alanmimms/WSPR-easy/hw/WSPR-ease.kicad_pcb

## KiCad design hw/WSPR-ease.kicad_pcb (2026-04-10)

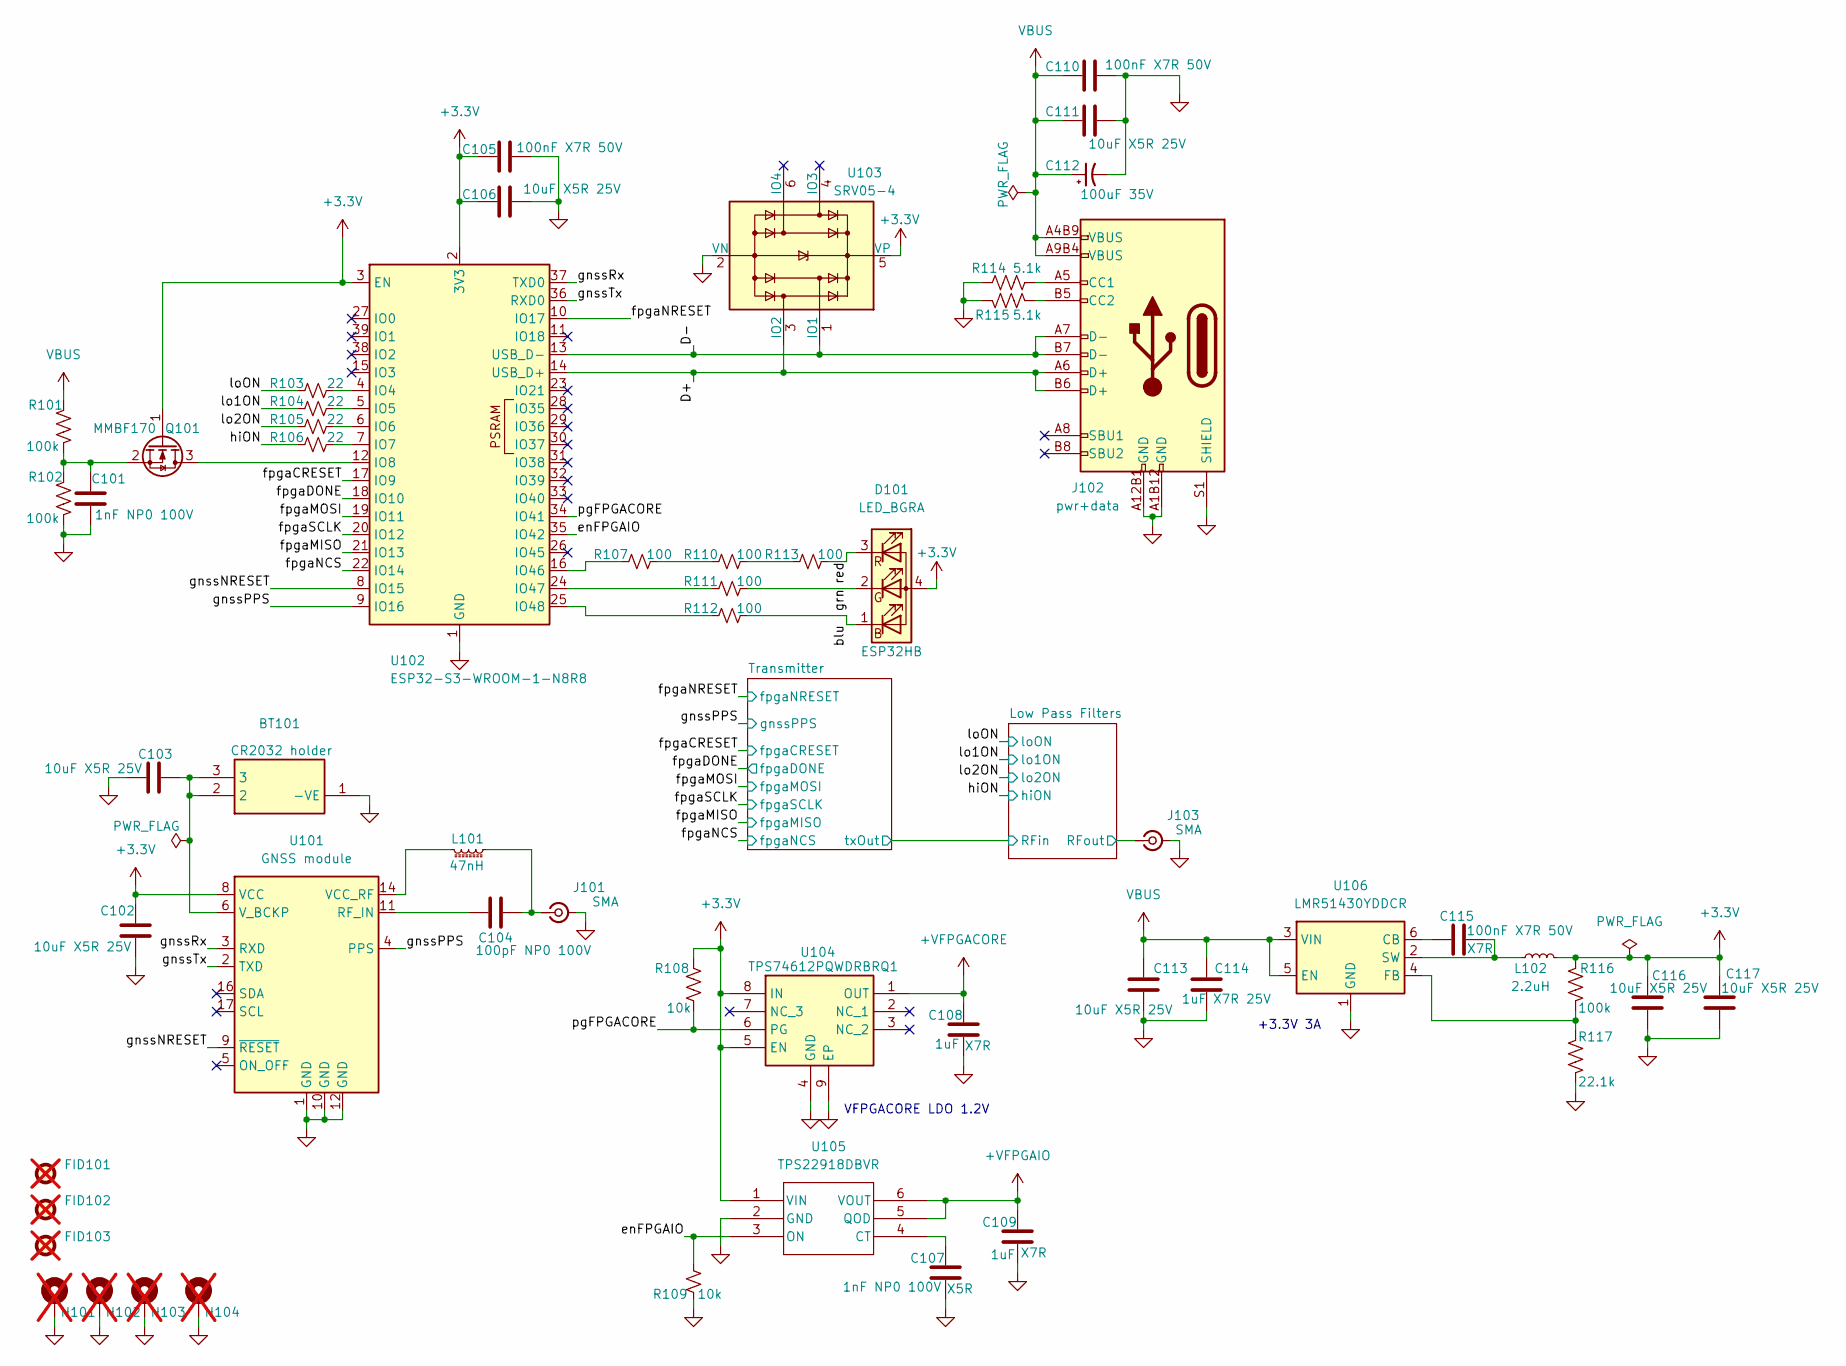
[picture p1: schematic WSPR-ease.kicad_sch, WSPR Ease]

Parts:
BT101: CR2032 holder; S8401-46; Mouser Part Number 855-S8401-46; LCSC C6750449
C101: 1nF NP0 100V; C_0603_1608Metric; MPN KGM15ACG2A102FT; LCSC C5182455
C102, C103, C106, C111: 10uF X5R 25V; C_0603_1608Metric; MPN CM105X5R106M25AT; LCSC C96446
C104: 100pF NP0 100V; C_0603_1608Metric; MPN KGM15ACG2A101FT; LCSC C106200
C105, C110: 100nF X7R 50V; C_0603_1608Metric; MPN KGM15BR71H104KT; LCSC C24452
C107: 1nF NP0 100V; C_0603_1608Metric; MPN KGM15ACG2A102FT; LCSC_PN C301928
C108, C109: 1uF; C_0402_1005Metric; MPN GRM155Z71A105KE1D; LCSC_PN C301928
C112: 100uF 35V; C_Elec_8x6.2; MPN MAL214297007E3; LCSC C1849748
C113: 10uF X5R 25V; C_0603_1608Metric; MPN CM105X5R106M25AT; LCSC_PN C327087
C114: 1uF X7R 25V; C_0603_1608Metric; MPN CM105X7R105K25AT; LCSC_PN C301928
C115: 100nF X7R 50V; C_0603_1608Metric; MPN KGM15BR71H104KT; LCSC_PN C24452
C116, C117: 10uF X5R 25V; C_0603_1608Metric; Manufacturer_Part_Number 81-GXT155R71E223KE1D; Mouser Part Number 963-MLAST168BB5106MT
D101: LED_BGRA; UHD111AFKAC3K23E1L3VG5ZB3Z3; MPN UHD111A-FKA-C3K23E1L3VG5ZB3Z3; Mouser_PN 941-UHD1AA3K3E3V53Z3
FID101, FID102, FID103: Fiducial; Fiducial_1mm_Mask2mm; LCSC DNP; not fitted
H101, H102, H103, H104: MountingHole_Pad; MountingHole_3.2mm_M3_ISO7380_Pad; LCSC DNP; not fitted
J101, J103: SMA; SMA_Amphenol_901-143_Horizontal; MPN SMA-J-P-H-RA-TH1; LCSC C496551
J102: pwr+data; USB_C_Receptacle_HRO_TYPE-C-31-M-12-bursted; MPN TYPE-C-31-M-12; LCSC_PN C165948
L101: 47nH; L_0603_1608Metric; MPN AIMC-0603-47NJ-T; LCSC C98076
L102: 2.2uH; L_1008_2520Metric; MPN AIML-1008HC-2R2M-T; LCSC_PN C86089
Q101: MMBF170; SOT-23; MPN MMBF170Q-13-F; LCSC C28871
R101, R102: 100k; R_0402_1005Metric; MPN CRT0402-FZ-1003GLF; LCSC C60491
R103, R104, R105, R106: 22; R_0402_1005Metric
R107, R110, R111, R112, R113: 100; R_0402_1005Metric
R108: 10k; R_0402_1005Metric; MPN CRT0402-FZ-1003GLF; LCSC_PN C728576
R109: 10k; R_0402_1005Metric
R114, R115: 5.1k; R_0402_1005Metric; MPN MCS04020C5101FE000; LCSC_PN C854378
R116: 100k; R_0402_1005Metric; MPN CRT0402-FZ-1003GLF; LCSC_PN C728576
R117: 22.1k; R_0402_1005Metric; MPN RT0402FRD0722K1L; LCSC_PN C284424
U101: GNSS module; ublox_MAX; MPN TESEO-LIV3R; LCSC C90770
U102: ESP32-S3-WROOM-1-N8R8; ESP32-S3-WROOM-1; Mouser Part Number ESP32-S3-WROOM-1-N8R8; LCSC C2913204
U103: SRV05-4; SOT-23-6; MPN SRV05-4.TCT; LCSC C2836319
U104: TPS74612PQWDRBRQ1; SON65P300X300X100-9N-D; MPN TPS74612PQWDRBRQ1; LCSC_PN C2868254
U105: TPS22918DBVR; DBV6_TEX; MPN TPS22918DBVR; LCSC_PN C131941
U106: LMR51430YDDCR; SOT-23-6; MPN LMR51430YDDCR; LCSC_PN C5185863

Connections:
+3.3V: C102.1, C105.1, C106.1, C116.1, C117.1, D101.4 (A), L102.2, Q101.1 (G), R108.2, R116.2, U101.8 (VCC), U102.2 (3V3), U102.3 (EN), U103.5 (VP), U104.5 (EN), U104.8 (IN), U105.1 (VIN); also elsewhere on the board
+VFPGACORE: C108.1, U104.1 (OUT); also elsewhere on the board
+VFPGAIO: C109.1, U105.5 (QOD), U105.6 (VOUT); also elsewhere on the board
/D+: J102.A6 (D+), J102.B6 (D+), U102.14 (USB_D+), U103.3 (IO2)
/D-: J102.A7 (D-), J102.B7 (D-), U102.13 (USB_D-), U103.1 (IO1)
/Low Pass Filters/RFout: J103.1 (In); also elsewhere on the board
/blu: D101.1 (BK), R112.2
/enFPGAIO: R109.2, U102.35 (IO42), U105.3 (ON)
/fpgaCRESET: U102.17 (IO9); also elsewhere on the board
/fpgaDONE: U102.18 (IO10); also elsewhere on the board
/fpgaMISO: U102.21 (IO13); also elsewhere on the board
/fpgaMOSI: U102.19 (IO11); also elsewhere on the board
/fpgaNCS: U102.22 (IO14); also elsewhere on the board
/fpgaNRESET: U102.10 (IO17); also elsewhere on the board
/fpgaSCLK: U102.20 (IO12); also elsewhere on the board
/gnssNRESET: U101.9 (~RESET), U102.8 (IO15)
/gnssPPS: U101.4 (PPS), U102.9 (IO16); also elsewhere on the board
/gnssRx: U101.3 (RXD), U102.37 (TXD0)
/gnssTx: U101.2 (TXD), U102.36 (RXD0)
/grn: D101.2 (GK), R111.2
/hiON: R106.1; also elsewhere on the board
/lo1ON: R104.1; also elsewhere on the board
/lo2ON: R105.1; also elsewhere on the board
/loON: R103.1; also elsewhere on the board
/pgFPGACORE: R108.1, U102.34 (IO41), U104.6 (PG)
/red: D101.3 (RK), R113.2
GND: BT101.1 (-VE), C101.2, C102.2, C103.1, C105.2, C106.2, C107.2, C108.2, C109.2, C110.2, C111.2, C112.2, C113.2, C114.2, C116.2, C117.2, H101.1, H102.1, H103.1, H104.1, J101.2 (Ext), J102.A1B12 (GND), J102.A12B1 (GND), J102.S1 (SHIELD), J103.2 (Ext), R102.2, R109.1, R114.2, R115.2, R117.1, U101.1 (GND), U101.10 (GND), U101.12 (GND), U102.1 (GND), U102.40 (GND), U102.41 (GND), U103.2 (VN), U104.4 (GND), U104.9 (EP), U105.2 (GND), U106.1 (GND); also elsewhere on the board
unnamed: C104.2, J101.1 (In), L101.2
unnamed: J102.A5 (CC1), R114.1
unnamed: J102.B5 (CC2), R115.1
unnamed: Q101.3 (D), U102.12 (IO8)
unnamed: C101.1, Q101.2 (S), R101.2, R102.1
unnamed: R107.2, R110.1
unnamed: R110.2, R113.1
unnamed: C104.1, U101.11 (RF_IN)
unnamed: L101.1, U101.14 (VCC_RF)
unnamed: BT101.2, BT101.3, C103.2, U101.6 (V_BCKP)
unnamed: R103.2, U102.4 (IO4)
unnamed: R104.2, U102.5 (IO5)
unnamed: R105.2, U102.6 (IO6)
unnamed: R106.2, U102.7 (IO7)
unnamed: R107.1, U102.16 (IO46)
unnamed: R111.1, U102.24 (IO47)
unnamed: R112.1, U102.25 (IO48)
unnamed: C107.1, U105.4 (CT)
unnamed: C115.1, U106.6 (CB)
unnamed: R116.1, R117.2, U106.4 (FB)
unnamed: C115.2, L102.1, U106.2 (SW)
VBUS: C110.1, C111.1, C112.1, C113.1, C114.1, J102.A4B9 (VBUS), J102.A9B4 (VBUS), R101.1, U106.3 (VIN), U106.5 (EN); also elsewhere on the board

Notes on the sheet:
VFPGACORE LDO 1.2V
+3.3V 3A

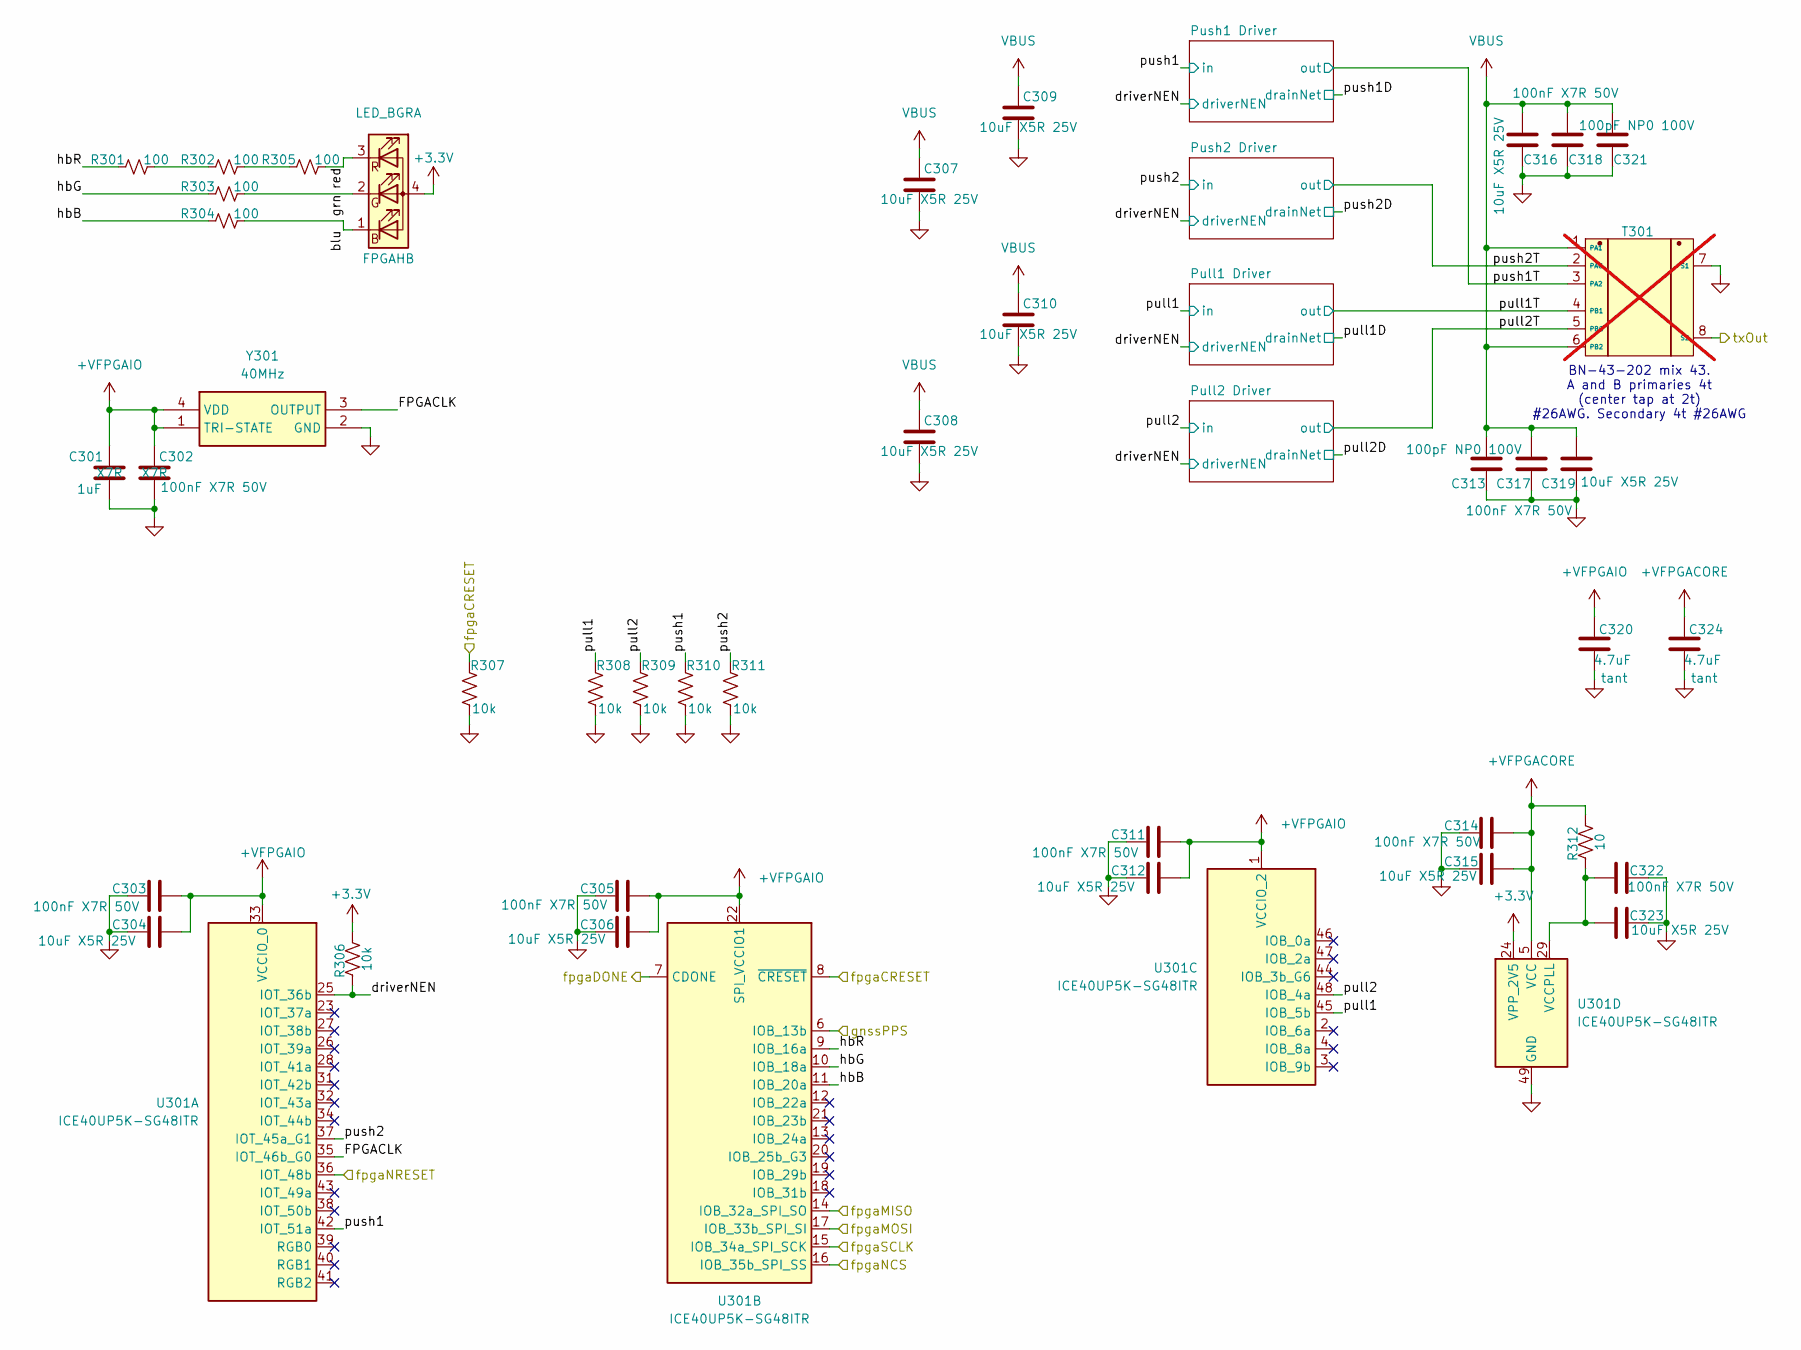
[picture p2: schematic tx.kicad_sch]

Parts:
C301: 1uF; C_0402_1005Metric; MPN GRM155Z71A105KE1D; LCSC_PN C301928
C302: 100nF X7R 50V; C_0603_1608Metric; MPN KGM15BR71H104KT; LCSC_PN C24452
C303, C305, C311, C314, C317, C318, C322: 100nF X7R 50V; C_0603_1608Metric; MPN KGM15BR71H104KT; LCSC C24452
C304, C306, C307, C308, C309, C310, C312, C315, C316, C319, C323: 10uF X5R 25V; C_0603_1608Metric; MPN CM105X5R106M25AT; LCSC C96446
C313, C321: 100pF NP0 100V; C_0603_1608Metric; MPN KGM15ACG2A101FT; LCSC C106200
C320, C324: 4.7uF; C_0402_1005Metric; MPN CM05X5R475M10AH; LCSC_PN C18535241
D301: LED_BGRA; UHD111AFKAC3K23E1L3VG5ZB3Z3; MPN UHD111A-FKA-C3K23E1L3VG5ZB3Z3; Mouser_PN 941-UHD1AA3K3E3V53Z3
R301, R302, R303, R304, R305: 100; R_0402_1005Metric
R306: 10k; R_0402_1005Metric; MPN MCT06030C1009FP500; LCSC C2907091
R307, R308, R309, R310, R311: 10k; R_0402_1005Metric; MPN MCS04020C1002FE000; LCSC C60490
R312: 10; R_0603_1608Metric; MPN MCT06030C1009FP500; LCSC C2907091
T301: BN-43-202_DualPri_CTSec; bn-43-202-horizontal; MPN 2843000202; LCSC C7174817; not fitted
U301: ICE40UP5K-SG48ITR; QFN-48-1EP_7x7mm_P0.5mm_EP5.6x5.6mm; MPN ICE40UP5K-SG48I; LCSC C2678152
Y301: 40MHz; ECSTXO201633400TR; MPN ECS-TXO-2016-33-400-TR; LCSC_PN C2451471

Connections:
+3.3V: D301.4 (A), R306.2, U301.24 (VPP_2V5); also elsewhere on the board
+VFPGACORE: C314.2, C315.2, C324.1, R312.2, U301.5 (VCC), U301.30 (VCC); also elsewhere on the board
+VFPGAIO: C301.1, C302.1, C303.2, C304.2, C305.2, C306.2, C311.2, C312.2, C320.1, U301.1 (VCCIO_2), U301.22 (SPI_VCCIO1), U301.33 (VCCIO_0), Y301.1 (TRI-STATE), Y301.4 (VDD); also elsewhere on the board
/Low Pass Filters/RFin: T301.8 (S2); also elsewhere on the board
/Transmitter/FPGACLK: U301.35 (IOT_46b_G0), Y301.3 (OUTPUT)
/Transmitter/blu: D301.1 (BK), R304.2
/Transmitter/driverNEN: R306.1, U301.25 (IOT_36b); also elsewhere on the board
/Transmitter/grn: D301.2 (GK), R303.2
/Transmitter/hbB: R304.1, U301.11 (IOB_20a)
/Transmitter/hbG: R303.1, U301.10 (IOB_18a)
/Transmitter/hbR: R301.1, U301.9 (IOB_16a)
/Transmitter/pull1: R308.1, U301.45 (IOB_5b); also elsewhere on the board
/Transmitter/pull1T: T301.4 (PB1); also elsewhere on the board
/Transmitter/pull2: R309.1, U301.48 (IOB_4a); also elsewhere on the board
/Transmitter/pull2T: T301.5 (PBC); also elsewhere on the board
/Transmitter/push1: R310.1, U301.42 (IOT_51a); also elsewhere on the board
/Transmitter/push1T: T301.3 (PA2); also elsewhere on the board
/Transmitter/push2: R311.1, U301.37 (IOT_45a_G1); also elsewhere on the board
/Transmitter/push2T: T301.2 (PAC); also elsewhere on the board
/Transmitter/red: D301.3 (RK), R305.2
/fpgaCRESET: R307.1, U301.8 (~CRESET); also elsewhere on the board
/fpgaDONE: U301.7 (CDONE); also elsewhere on the board
/fpgaMISO: U301.14 (IOB_32a_SPI_SO); also elsewhere on the board
/fpgaMOSI: U301.17 (IOB_33b_SPI_SI); also elsewhere on the board
/fpgaNCS: U301.16 (IOB_35b_SPI_SS); also elsewhere on the board
/fpgaNRESET: U301.36 (IOT_48b); also elsewhere on the board
/fpgaSCLK: U301.15 (IOB_34a_SPI_SCK); also elsewhere on the board
/gnssPPS: U301.6 (IOB_13b); also elsewhere on the board
GND: C301.2, C302.2, C303.1, C304.1, C305.1, C306.1, C307.1, C308.1, C309.1, C310.1, C311.1, C312.1, C313.1, C314.1, C315.1, C316.1, C317.1, C318.1, C319.1, C320.2, C321.1, C322.1, C323.1, C324.2, R307.2, R308.2, R309.2, R310.2, R311.2, T301.7 (S1), U301.49 (GND), Y301.2 (GND); also elsewhere on the board
unnamed: R301.2, R302.1
unnamed: R302.2, R305.1
unnamed: C322.2, C323.2, R312.1, U301.29 (VCCPLL)
VBUS: C307.2, C308.2, C309.2, C310.2, C313.2, C316.2, C317.2, C318.2, C319.2, C321.2, T301.1 (PA1), T301.6 (PB2); also elsewhere on the board

Notes on the sheet:
BN-43-202 mix 43. A and B primaries 4t (center tap at 2t) #26AWG. Secondary 4t #26AWG

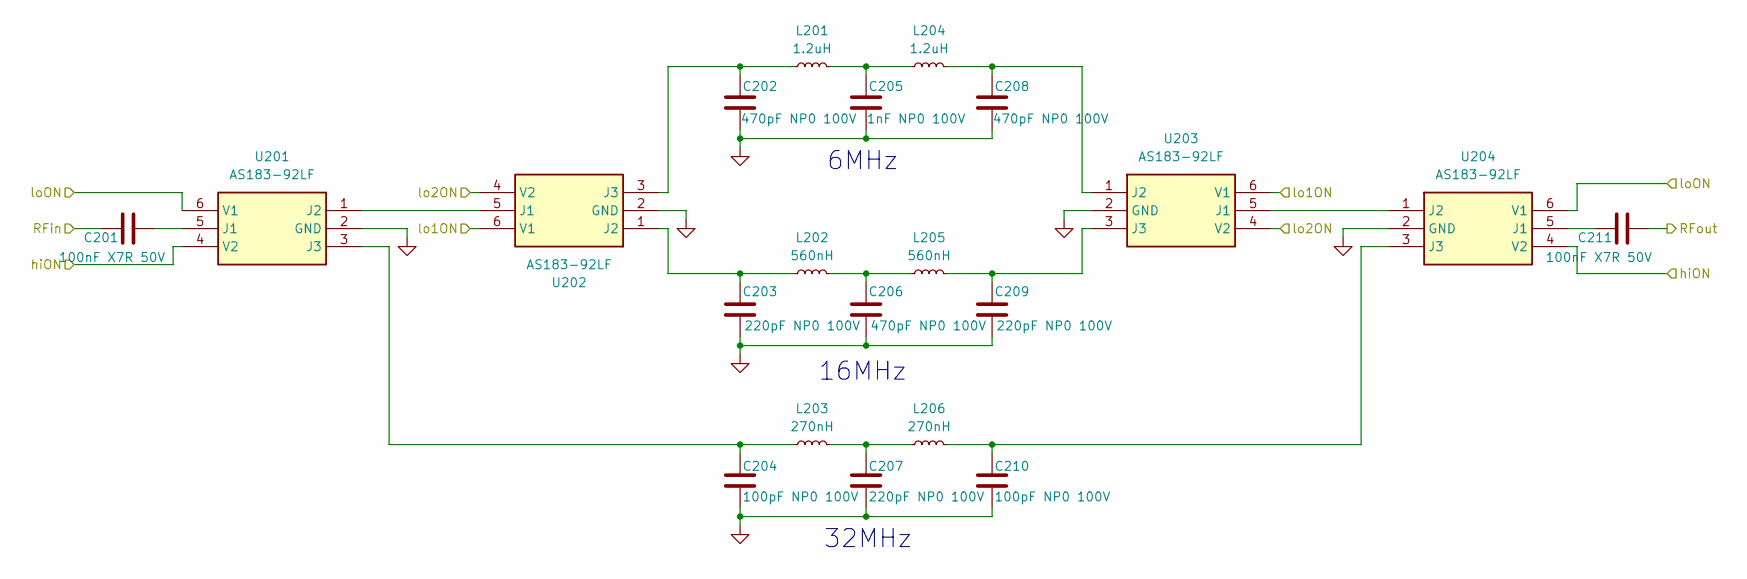
[picture p3: schematic LPFs.kicad_sch, Low Pass Filters]

Parts:
C201, C211: 100nF X7R 50V; C_0603_1608Metric; MPN KGM15BR71H104KT; LCSC C24452
C202, C206, C208: 470pF NP0 100V; C_0603_1608Metric; MPN GCM1885C2A471FA6D; LCSC C106259
C203, C207, C209: 220pF NP0 100V; C_0603_1608Metric; MPN GCM1885C2A221FA6D; LCSC C107001
C204, C210: 100pF NP0 100V; C_0603_1608Metric; MPN KGM15ACG2A101FT; LCSC C106200
C205: 1nF NP0 100V; C_0603_1608Metric; MPN KGM15ACG2A102FT; LCSC C5182455
L201, L204: 1.2uH; L_1008_2520Metric; MPN CW252016-1R2J; LCSC C2044063
L202, L205: 560nH; L_1008_2520Metric; MPN LQW2UASR56G00L; LCSC C6364717
L203, L206: 270nH; L_0805_2012Metric; MPN CW252016-R27J; LCSC C404430
U201, U202, U203, U204: AS183-92LF; SOT65P220X110-6N; Mouser Part Number 873-AS183-92LF

Connections:
/Low Pass Filters/RFin: C201.1; also elsewhere on the board
/Low Pass Filters/RFout: C211.2; also elsewhere on the board
/hiON: U201.4 (V2), U204.4 (V2); also elsewhere on the board
/lo1ON: U202.6 (V1), U203.6 (V1); also elsewhere on the board
/lo2ON: U202.4 (V2), U203.4 (V2); also elsewhere on the board
/loON: U201.6 (V1), U204.6 (V1); also elsewhere on the board
GND: C202.2, C203.2, C204.2, C205.2, C206.2, C207.2, C208.2, C209.2, C210.2, U201.2 (GND), U202.2 (GND), U203.2 (GND), U204.2 (GND); also elsewhere on the board
unnamed: C205.1, L201.2, L204.1
unnamed: C206.1, L202.2, L205.1
unnamed: C207.1, L203.2, L206.1
unnamed: C201.2, U201.5 (J1)
unnamed: U201.1 (J2), U202.5 (J1)
unnamed: C204.1, L203.1, U201.3 (J3)
unnamed: C203.1, L202.1, U202.1 (J2)
unnamed: C202.1, L201.1, U202.3 (J3)
unnamed: U203.5 (J1), U204.1 (J2)
unnamed: C208.1, L204.2, U203.1 (J2)
unnamed: C209.1, L205.2, U203.3 (J3)
unnamed: C211.1, U204.5 (J1)
unnamed: C210.1, L206.2, U204.3 (J3)

Notes on the sheet:
6MHz
32MHz
16MHz

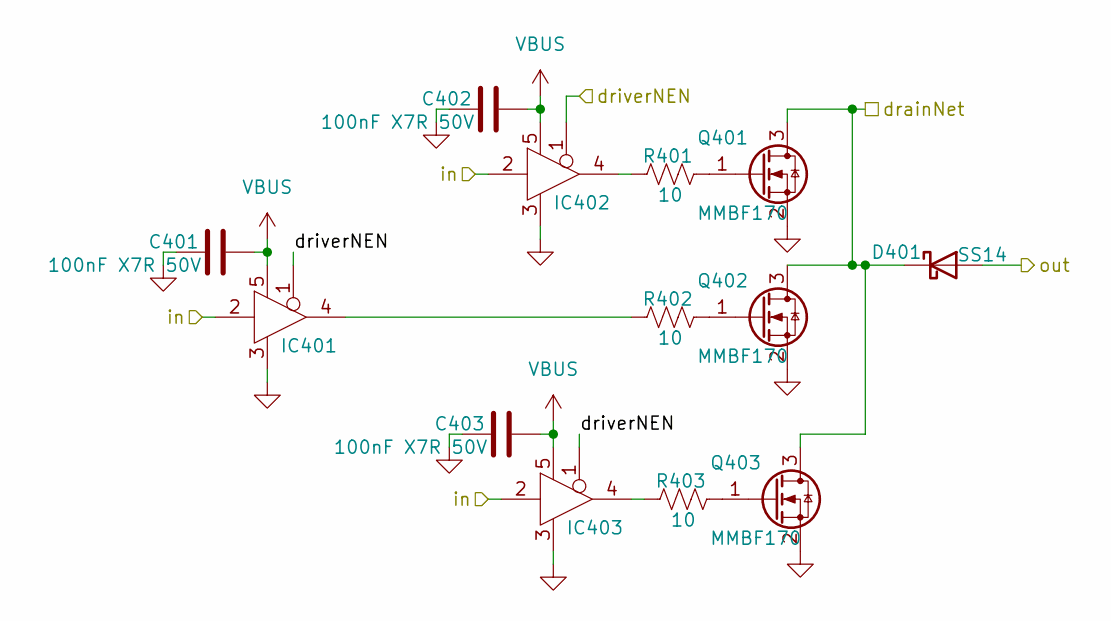
[picture p4: schematic phase-driver.kicad_sch]

Parts:
C401, C402, C403: 100nF X7R 50V; C_0603_1608Metric; MPN KGM15BR71H104KT; LCSC C24452
D401: SS14; D_SMA; MPN SS14; LCSC C83852
IC401, IC402, IC403: SN74AHCT1G125DRLR; SOTFL50P160X60-5N; Mouser Part Number 595-SN74AHCT1G125DRL
Q401, Q402, Q403: MMBF170; SOT-23; MPN MMBF170Q-13-F; LCSC C28871
R401, R402, R403: 10; R_0603_1608Metric; MPN MCT06030C1009FP500; LCSC C2907091

Connections:
/Transmitter/driverNEN: IC401.1 (~OE), IC402.1 (~OE), IC403.1 (~OE); also elsewhere on the board
/Transmitter/push1: IC401.2 (A), IC402.2 (A), IC403.2 (A); also elsewhere on the board
/Transmitter/push1D: D401.1 (K), Q401.3 (D), Q402.3 (D), Q403.3 (D)
/Transmitter/push1T: D401.2 (A); also elsewhere on the board
GND: C401.1, C402.1, C403.1, IC401.3 (GND), IC402.3 (GND), IC403.3 (GND), Q401.2 (S), Q402.2 (S), Q403.2 (S); also elsewhere on the board
unnamed: IC401.4 (Y), R402.1
unnamed: IC402.4 (Y), R401.1
unnamed: IC403.4 (Y), R403.1
unnamed: Q401.1 (G), R401.2
unnamed: Q402.1 (G), R402.2
unnamed: Q403.1 (G), R403.2
VBUS: C401.2, C402.2, C403.2, IC401.5 (VCC), IC402.5 (VCC), IC403.5 (VCC); also elsewhere on the board

Parts of its further copies:
C501, C502, C503, C601, C602, C603, C701, C702, C703: 100nF X7R 50V; C_0603_1608Metric; MPN KGM15BR71H104KT; LCSC C24452
D501, D601, D701: SS14; D_SMA; MPN SS14; LCSC C83852
IC501, IC502, IC503, IC601, IC602, IC603, IC701, IC702, IC703: SN74AHCT1G125DRLR; SOTFL50P160X60-5N; Mouser Part Number 595-SN74AHCT1G125DRL
Q501, Q502, Q503, Q601, Q602, Q603, Q701, Q702, Q703: MMBF170; SOT-23; MPN MMBF170Q-13-F; LCSC C28871
R501, R502, R503, R601, R602, R603, R701, R702, R703: 10; R_0603_1608Metric; MPN MCT06030C1009FP500; LCSC C2907091

Connections of its further copies:
/Transmitter/driverNEN: IC501.1 (~OE), IC502.1 (~OE), IC503.1 (~OE), IC601.1 (~OE), IC602.1 (~OE), IC603.1 (~OE), IC701.1 (~OE), IC702.1 (~OE), IC703.1 (~OE); also elsewhere on the board
/Transmitter/pull1: IC601.2 (A), IC602.2 (A), IC603.2 (A); also elsewhere on the board
/Transmitter/pull1D: D601.1 (K), Q601.3 (D), Q602.3 (D), Q603.3 (D)
/Transmitter/pull1T: D601.2 (A); also elsewhere on the board
/Transmitter/pull2: IC701.2 (A), IC702.2 (A), IC703.2 (A); also elsewhere on the board
/Transmitter/pull2D: D701.1 (K), Q701.3 (D), Q702.3 (D), Q703.3 (D)
/Transmitter/pull2T: D701.2 (A); also elsewhere on the board
/Transmitter/push2: IC501.2 (A), IC502.2 (A), IC503.2 (A); also elsewhere on the board
/Transmitter/push2D: D501.1 (K), Q501.3 (D), Q502.3 (D), Q503.3 (D)
/Transmitter/push2T: D501.2 (A); also elsewhere on the board
GND: C501.1, C502.1, C503.1, C601.1, C602.1, C603.1, C701.1, C702.1, C703.1, IC501.3 (GND), IC502.3 (GND), IC503.3 (GND), IC601.3 (GND), IC602.3 (GND), IC603.3 (GND), IC701.3 (GND), IC702.3 (GND), IC703.3 (GND), Q501.2 (S), Q502.2 (S), Q503.2 (S), Q601.2 (S), Q602.2 (S), Q603.2 (S), Q701.2 (S), Q702.2 (S), Q703.2 (S); also elsewhere on the board
unnamed: IC501.4 (Y), R502.1
unnamed: IC502.4 (Y), R501.1
unnamed: IC503.4 (Y), R503.1
unnamed: IC601.4 (Y), R602.1
unnamed: IC602.4 (Y), R601.1
unnamed: IC603.4 (Y), R603.1
unnamed: IC701.4 (Y), R702.1
unnamed: IC702.4 (Y), R701.1
unnamed: IC703.4 (Y), R703.1
unnamed: Q501.1 (G), R501.2
unnamed: Q502.1 (G), R502.2
unnamed: Q503.1 (G), R503.2
unnamed: Q601.1 (G), R601.2
unnamed: Q602.1 (G), R602.2
unnamed: Q603.1 (G), R603.2
unnamed: Q701.1 (G), R701.2
unnamed: Q702.1 (G), R702.2
unnamed: Q703.1 (G), R703.2
VBUS: C501.2, C502.2, C503.2, C601.2, C602.2, C603.2, C701.2, C702.2, C703.2, IC501.5 (VCC), IC502.5 (VCC), IC503.5 (VCC), IC601.5 (VCC), IC602.5 (VCC), IC603.5 (VCC), IC701.5 (VCC), IC702.5 (VCC), IC703.5 (VCC); also elsewhere on the board

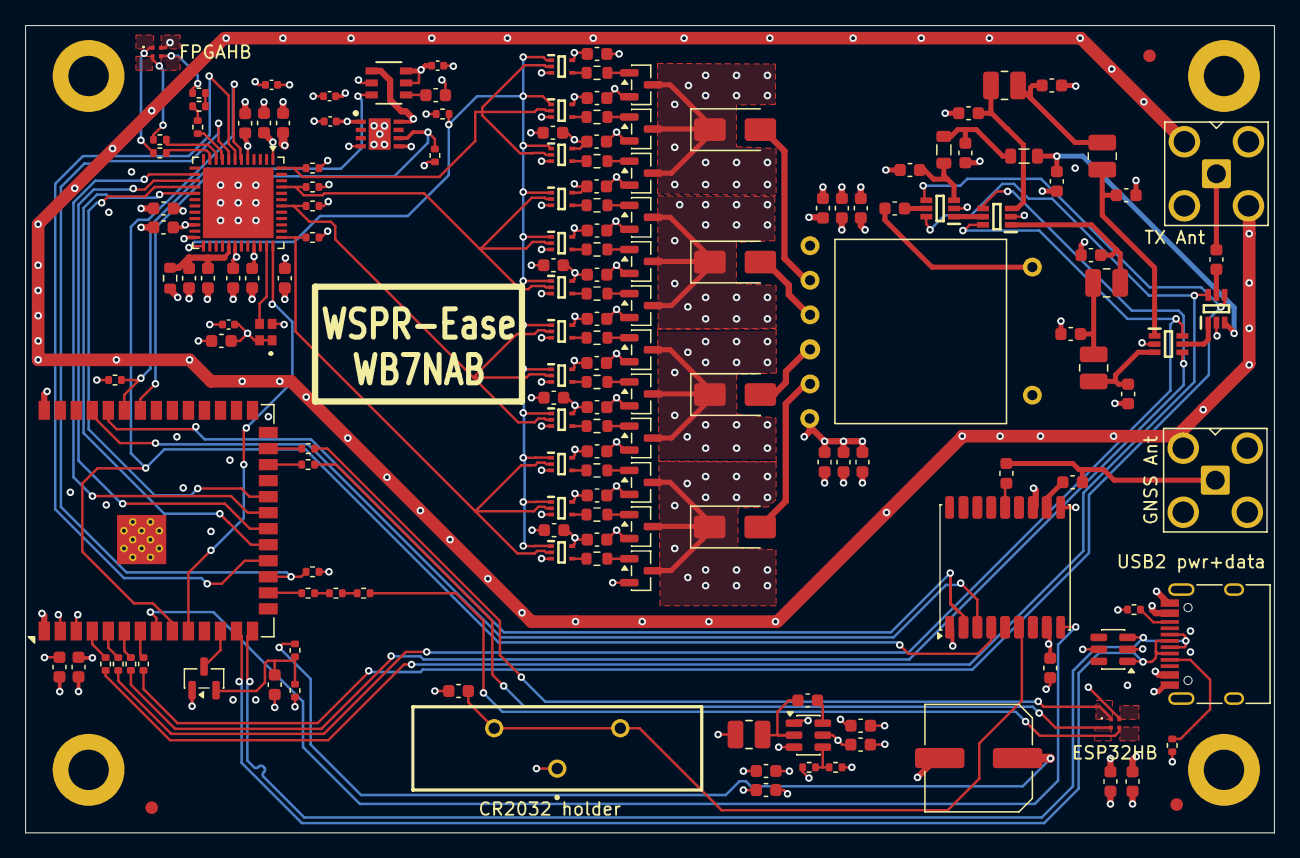
[picture p5: board WSPR-ease.kicad_pcb from above]

Board: 4 copper layers, 99.0 x 64.0 mm, 168 parts (0 on the bottom side), 110 nets.
