alanmimms/WSPR-easy/FPGA/pins.pcf

# Clock Inputs
set_io fpgaSCLK_pin 15
set_io clk40 35
set_io gnssPPS 6

# SPI Interface (Standard 4mA is fine for these)
set_io fpgaMOSI 17
set_io fpgaNCS 16
set_io fpgaMISO 14

# RF Exciter Outputs (DDR Capable, 12mA High Drive)
set_io rfPushBase 42
set_io rfPushPeak 37
set_io rfPullBase 45
set_io rfPullPeak 48
set_io driverNEN 25

# Reset without reconfiguration
set_io fpgaNRESET 36
