alanmimms/WSPR-easy/FPGA/simHAL.hpp

#pragma once

#include "../sw/hal/hal.hpp"
#include "VTop.h"
#include <cstdint>
#include <vector>

/**
 * @brief SPI HAL implementation for Verilator simulation.
 *
 * This implementation drives the SPI signals in the VTop module
 * to send commands and data to the FPGA.
 */
class SimSpi : public HAL::ISpi {
public:
  SimSpi(VTop* top, vluint64_t* simTime)
    : top(top), simTime(simTime) {}

  void write(const uint8_t* data, size_t len) override {
    transceive(data, nullptr, len);
  }

  void transceive(const uint8_t* txData, uint8_t* rxData, size_t len) {
    // Assert CS
    top->fpgaNCS = 0;
    advanceClock(2);

    for (size_t b = 0; b < len; b++) {
      uint8_t txByte = txData[b];
      uint8_t rxByte = 0;

      for (int i = 7; i >= 0; i--) {
        top->fpgaMOSI = (txByte >> i) & 1;
        
        // Rise SCLK
        top->fpgaSCLK_pin = 1;
        advanceClock(10); // Wait 5 full cycles
        
        // Sample MISO on Rising Edge (Mode 0)
        rxByte = (rxByte << 1) | (top->fpgaMISO & 1);
        
        // Fall SCLK
        top->fpgaSCLK_pin = 0;
        advanceClock(10); // Wait 5 full cycles
      }
      
      if (rxData) {
        rxData[b] = rxByte;
      }
    }

    // Deassert CS
    top->fpgaNCS = 1;
    advanceClock(2);
  }

  // Helper for 5-byte register write
  void writeReg(uint8_t reg, uint32_t value) {
    uint8_t buf[5];
    buf[0] = 0x80 | (reg & 0x7F);
    buf[1] = (value >> 24) & 0xFF;
    buf[2] = (value >> 16) & 0xFF;
    buf[3] = (value >> 8) & 0xFF;
    buf[4] = value & 0xFF;
    write(buf, 5);
  }

  // Helper for 5-byte register read
  uint32_t readReg(uint8_t reg) {
    uint8_t tx[5] = { (uint8_t)(reg & 0x7F), 0, 0, 0, 0 };
    uint8_t rx[5] = { 0 };
    transceive(tx, rx, 5);
    return ((uint32_t)rx[1] << 24) | ((uint32_t)rx[2] << 16) | 
           ((uint32_t)rx[3] << 8) | (uint32_t)rx[4];
  }

private:
  VTop* top;
  vluint64_t* simTime;

  void advanceClock(int cycles) {
    for (int i = 0; i < cycles; i++) {
      top->clk40 = !top->clk40;
      top->eval();
      *simTime += 12500; // 12.5ns = 12500ps (40 MHz)
    }
  }
};

/**
 * @brief Timer HAL implementation for Verilator simulation.
 *
 * Tracks simulation time in picoseconds.
 */
class SimTimer : public HAL::ITimer {
public:
  SimTimer(vluint64_t* simTime) : simTime(simTime) {}

  int64_t getUptimeMs() override {
    return *simTime / 1000000000LL; // ps to ms
  }

  int64_t getUptimePs() override {
    return *simTime;
  }

  void sleepMs(int32_t ms) override {
    // No-op in simulation
  }

private:
  vluint64_t* simTime;
};
