alanmimms/WSPR-easy/(commit log)

2025-11-26 Starting layout a bit
    [WSPR-ease.kicad_pcb, WSPR-ease.kicad_sch, bom.csv, ether.kicad_sch, tx.kicad_sch]
2025-11-27 Fix filters for proper response. Now we have FPGA + ESP32S3.
    [LPFs.kicad_sch, WSPR-ease.kicad_sch, ether.kicad_sch, iCE40UltraUltraPlusSG48PinMigration.ods, tx.kicad_sch]
2025-11-29 Well it is routed and passes DRC
    [CD74ACT541M96G4.SchLib, CD74ACT541M96G4.stp, EDI2CAP.CFG, LPFs.kicad_sch, SOIC127P1030X265-20N.PcbLib, WSPR-ease.kicad_pcb, WSPR-ease.kicad_sch, chips.prt]
2025-11-29 Minor tweaks after submitting 001 build to pcbway
    [2843000202.STEP, 85_SMA-50-0-144_111_YH.STEP, AS183-92LF.stp, EDI2CAP.CFG, ICE40UP5K-SG48I.SchLib, ICE40UP5K-SG48I.stp, LPFs.kicad_sch, MOD18_MAX-M10M_UBL.step]
2025-12-02 Submitted to PCBway (I had to update BOM after oops)
    [BOM_WSPR-ease.kicad_pcb (1).xls, LPFs.kicad_sch, WSPR-ease-outline.step, WSPR-ease.kicad_sch, tx.kicad_sch]
2025-12-03 Cleanup. Better USB diff pair with 0ohm and TVS as recommended. Return to rectangular outline and even smaller. Mounting holes are consistently placed relative to board corners.
    [LPFs.kicad_sch, WSPR-ease.kicad_pcb, WSPR-ease.kicad_sch, tx.kicad_sch]
2025-12-04 Add FPGA Verilator testbench integrated with ESP32 SW stack
    Implements complete hardware-in-the-loop simulation capability for
    WSPR-ease. The testbench drives the FPGA RTL using the actual ESP32
    transmitter and WSPR encoder code via a hardware abstraction layer.
    FPGA Components:
    - Complete iCE40UP5K design with 200 Msps NCO and 6-step sequencer
    - SPI slave interface for tuning word updates
    - PPS counter for TCXO calibration
    - DDR output primitives for RF PA drive signals
    - Simulation models for SB_IO and SB_PLL40_CORE
    Software Integration:
    - HAL abstractions (ISpi, ITimer) in sw/hal/hal.hpp
    - Refactored Transmitter and WSPREncoder to work in both embedded and sim
    - SimSpi and SimTimer impl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
2025-12-04 Add event-driven fast-forward mode for 4500x simulation speedup
    Implements conditional event-driven simulation that skips clock cycles
    between WSPR symbol transmissions, dramatically reducing simulation time
    while maintaining functional verification accuracy.
    Performance improvements:
    - Superfast mode: 0.011s (4545x faster than full, 691x faster than fast)
    - Fast mode: 7.6s (6.6x faster than full)
    - Full mode: ~50s (baseline with waveforms)
    Implementation:
    - Added --fastforward command-line option to tb_top.cpp
    - Event-driven time jumping: skips to 10µs before each symbol
    - Only evaluates hardware during active SPI transaction periods
    - Reduces simulated clock cycles from 102M to ~1500 pe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
2025-12-04 Add web UI mock server for WSPR-ease configuration
    Mock server environment for developing/testing web UI before ESP32 deployment.
    Includes REST API for file ops, config management, and status. Mobile-friendly
    responsive UI with file upload/download/delete functionality.
2025-12-04 Add 60m band, fix signal handling, add online/offline status
    - Add 60m band (5.2872 MHz) to scheduler, now 9 bands total (80m-10m)
    - Fix server signal handling to properly shut down on Ctrl+C
    - Add ONLINE/OFFLINE status indicator to web UI status bar
    - Status polling updates connection state every 2 seconds
    [config.hpp, config_manager.hpp, main.cpp]
2025-12-04 Fix status bar layout and default power level
    - Use CSS grid for status bar with fixed-width columns to prevent shifting
    - Change default power from 23dBm (200mW) to 30dBm (1W) for WSPR-ease HW
    - Show wattage alongside dBm in power dropdown (e.g., "30 (1W)")
    - Mobile responsive: 3 columns on narrow screens
    [config.hpp]
2025-12-05 Add flexible band scheduling with time windows and version cache busting
    - Add per-band time windows with UTC, local, sunrise, and sunset bases
    - Change scheduling modes to Manual, Random, Round-Robin, and List
    - Add bandList field for weighted band selection (e.g., "20m,20m,40m")
    - Move Trigger TX button to top bar, add Save/Cancel with dirty tracking
    - Add version hash computed from www files at build time
    - Add /api/version endpoint for cache busting with auto-reload on mismatch
    - Update config serialization for new TimeWindow structure
2025-12-06 Starting to run on ESP32S3 dev board for now until hw arrives
2025-12-06 Add LittleFS web server with full REST API and fix WiFi/DHCP connectivity
    - Add LittleFS partition (512KB) for web UI files at 0x310000
    - Implement complete REST API: /api/version, /api/config (GET/PUT),
    /api/tx/trigger, /api/files (list/get/put/delete), /api/status
    - Fix DHCP client by explicitly calling net_dhcpv4_start() after WiFi connects
    - Fix "already connected" check to verify IP is valid (not 0.0.0.0)
    - Remove singleton pattern from WebServer to fix corrupt this pointer crash
    - Increase CONFIG_NET_MAX_CONN to 16 for concurrent browser requests
    - Increase main stack to 16KB, server thread stack to 8KB
    - Add network debug logging for troubleshooting
    - Serve static files from LittleF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
    [captive_dns.cpp, fpga.cpp, gnss.cpp, main.cpp, webserver.cpp, webserver.hpp]
2025-12-07 Add stitching vias to ground ring around RF zone
    [WSPR-ease.kicad_pcb]
2025-12-07 Switch to SSOP package for 74ACT541. Tweak a bunch of layout for DFM and maybe some improved SI.
    [CD74ACT541SM96.SchLib, CD74ACT541SM96.stp, EDI2CAP.CFG, SOP65P780X200-20N.PcbLib, WSPR-ease.kicad_pcb, chips.prt, sop65p780x200-20n.psm, tx.kicad_sch]
2025-12-07 Fix up 3d in footprints in lib so they stay put when I update PCB from schematic. Fix text labels for same issue.
    [WSPR-ease.kicad_pcb, WSPR-ease.kicad_sch, tx.kicad_sch]
2025-12-15 Some PCBWay clarifications
    [alan-comments-quotation1-T-P2W69401A-5sets-BOM_WSPR-ease.kicad_pcb(2025-12-15).csv, alan-comments-quotation1-T-P2W69401A-5sets-BOM_WSPR-ease.kicad_pcb(2025-12-15).xls, updated quotation1-T-P2W69401A-5sets-BOM_WSPR-ease.kicad_pcb(2025-12-02).ods]
2026-01-05 Fixes to pass ERC. Nothing serious really.
    [LPFs.kicad_sch, WSPR-ease.kicad_sch, tx.kicad_sch]
2026-03-02 Tarted up, 3d models applied, better footprints and BOM, ready to submit for PCBA
    [LPFs.kicad_sch, WSPR-ease.kicad_pcb, WSPR-ease.kicad_sch, tx.kicad_sch]
2026-03-02 Small changes to part numbers to ease supply chain issues for build
    [LPFs.kicad_sch, WSPR-ease.kicad_pcb, WSPR-ease.kicad_sch]
2026-03-03 Clean up signal quality and noise incursion into GNSS by moving some traces around
    [WSPR-ease.kicad_pcb]
2026-03-03 Reorg some dirs for tidiness
    [2843000202.STEP, 85_SMA-50-0-144_111_YH.STEP, AS183-92LF.stp, BOM_WSPR-ease.kicad_pcb (1).xls, CD74ACT541M96G4.SchLib, CD74ACT541M96G4.stp, CD74ACT541SM96.SchLib, CD74ACT541SM96.stp]
2026-03-03 Fix up 3d paths
    [WSPR-ease.kicad_pcb]
2026-03-15 Clean up some clearances found by FlashPCB tools
    [WSPR-ease.kicad_pcb]
2026-03-18 Cleanup and prep for MacroFab quote
    [WSPR-ease.kicad_pcb, WSPR-ease.kicad_sch]
2026-03-25 Parts ordered for DVT1 build
    [LPFs.kicad_sch, WSPR-ease.kicad_pcb, WSPR-ease.kicad_sch, tx.kicad_sch]
2026-03-26 About to redo the layout of the tx gate controls to match lengths
    [WSPR-ease.csv, WSPR-ease.kicad_pcb, WSPR-ease.kicad_sch, tx.kicad_sch]
2026-03-28 Fix huge oopsie with USB diode protection after having fixed the unforgivable polarity reversal and NOT SEEING THIS BUG. I can be an idiot sometimes.
    [WSPR-ease.kicad_pcb, WSPR-ease.kicad_sch, tx.kicad_sch]
2026-03-29 Testing on real hardware! And other than a D+/D- swap on USB it seems to work so far.
    [WSPR-ease.kicad_sch]
2026-03-29 Oops. Rx and Tx need to be swapped on GNSS
    [WSPR-ease.kicad_pcb, WSPR-ease.kicad_sch]
2026-03-29 Flash on nano1 remote host with WSPR-ease board attached to its USB
2026-03-29 Fixed reversed rx/tx on GNSS chip. Solved all ERC and DRC issues
    [WSPR-ease.kicad_pcb, WSPR-ease.kicad_sch, tx.kicad_sch]
2026-03-30 Implement real GNSS hardware integration with reset pulse and UART0 migration
    [WSPR-ease.kicad_pcb, WSPR-ease.kicad_sch]
2026-03-30 Functional but without FPGA loading working well yet
    [WSPR-ease.kicad_pcb, WSPR-ease.kicad_sch, tx.kicad_sch]
2026-03-31 Still working on FPGA config loading. Problem is now CMOS lockup caused by FPGACORE vs FPGAIO rails. I moved FPGAIO enable to IO42 on ESP32 and pgFPGACORE to IO41.
    [WSPR-ease.kicad_pcb, WSPR-ease.kicad_sch, tx.kicad_sch]
2026-03-31 Rename-o-rama to make coding style match my explicit guidelines (GEMINI ignores these for some reason). I have cleaned a few things up in the process. Code is somewhat broken right now as I prep for 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
    [WSPR-ease.kicad_pcb, WSPR-ease.kicad_sch]
2026-04-01 Refactor LittleFS to singleton, optimize memory usage, and fix FPGA power sequencing
    - Refactored LittleFS management into a wspr::FileSystem singleton
    - Moved thread stacks (WebServer, GNSS) and request buffers to the heap to reduce BSS usage and avoid DRAM overflow
    - Optimized FPGA bitstream loading with proper power sequencing for core and IO rails
    - Updated app.overlay with a clean partition table (explicitly deleting default partitions)
    - Updated flash-lfs.sh to extract partition info directly from zephyr.dts (single source of truth)
    - Improved WebServer stability and error logging for NVS configuration
    [filesystem.cpp, filesystem.hpp, fpga.cpp, gnss.cpp, main.cpp, webserver.cpp, webserver.hpp]
2026-04-01 Update docs to current fact
2026-04-01 Add 10k pullup to +3.3V for PG on FPGA CORE rail so we can read it from ESP32.
    [WSPR-ease.kicad_pcb, WSPR-ease.kicad_sch]
2026-04-02 Fix FPGA RF output and status reporting
    - Fixed FPGA SB_IO drive by connecting the clock and output enable
    - Corrected status bit alignment and added a heartbeat bit to FPGA registers
    - Improved FPGA build system and simulation test cases
    - Added initial LogManager and enhanced ESP32 shell commands for FPGA diagnostics
    [fpga.cpp, fpga.hpp, gnss.cpp, gnss.hpp, logmanager.cpp, logmanager.hpp, main.cpp]
2026-04-02 Start on the path to doing logging right, but still not great. Clean up some graphics in schematics
    [tx.kicad_sch]
2026-04-03 Now committed to using ESP32 sw to control modulation in realtime (1.6Hz is really easy). FPGA is timing now, but there is jitter on the output at 5.555555MHz. About to try another approach doing sep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
    [tx.kicad_sch]
2026-04-06 Separate FPGA config CRESET from software NRESET, add RGB heartbeat to FPGA.
    [WSPR-ease.kicad_pcb, WSPR-ease.kicad_sch, tx.kicad_sch]
2026-04-09 FPGA loading again. 5.555555MHz tx is jittery again.
    [WSPR-ease.kicad_sch]
2026-04-10 FPGA: Update PLL to 90MHz for 180MHz DDR RF output and optimize NCO pipeline for timing.
    - Updated PLL in top.sv to output 90MHz from 40MHz input.
    - Refactored WSPRExciter.sv with 8-stage 4-bit pipelined NCO to hit 90MHz timing.
    - Added explicit SB_GB buffers for clk90 and fpgaSCLK.
    - Updated simulation (tbTop.cpp, simHAL.hpp) and view_waveform.py.
    - Adjusted doc/SYSTEM_NOTES.md and sw/src/fpga.cpp constants to match 90MHz (180Msps DDR).
2026-04-10 FPGA: Fix NCO jitter via bit deskewing, optimize DDR timing, and correct frequency scaling.
    - Implemented bit deskewing in WSPRExciter.sv to align 4-bit NCO stages into a coherent 16-bit phase, resolving jitter.
    - Moved falling-edge DDR outputs to negedge registers to eliminate 5.5ns half-cycle bottlenecks.
    - Corrected sw/src/fpga.cpp to use 90MHz for tuning word calculation (fixed 2.25x scaling error).
    - Added synchronized reset for 90MHz domain in top.sv.
    - Added timescale declarations to all .sv files to fix Verilator warnings.
    [SPIRegisters.sv, WSPRExciter.sv, edgeDetector.sv, fpga.cpp, freqCounter.sv, syncronizer.sv, top.sv]
2026-04-10 Move to single gate buffer per MOSFET to distribute decoupling and gate drive across more devices and improve gate drive signal quality at high speed
    [WSPR-ease.kicad_pcb, WSPR-ease.kicad_sch, phase-driver.kicad_sch, tx.kicad_sch]
2026-04-10 These pins actually match the schematic
2026-04-11 Refactor shell commands: remove wspr prefix and redesign tx command
    [shellcmds.cpp]
2026-04-11 Make sure we send power 255 in control SPI write
2026-04-11 Add reboot command. Log when FPGA PLL is not locked but it has been loaded.
    [main.cpp, shellcmds.cpp]
